BallHamster/Mornigong_display/Kicad_files/Mornigong_disp.kicad_pcb

## KiCad design Kicad_files/Mornigong_disp.kicad_pcb (2026-11-01)

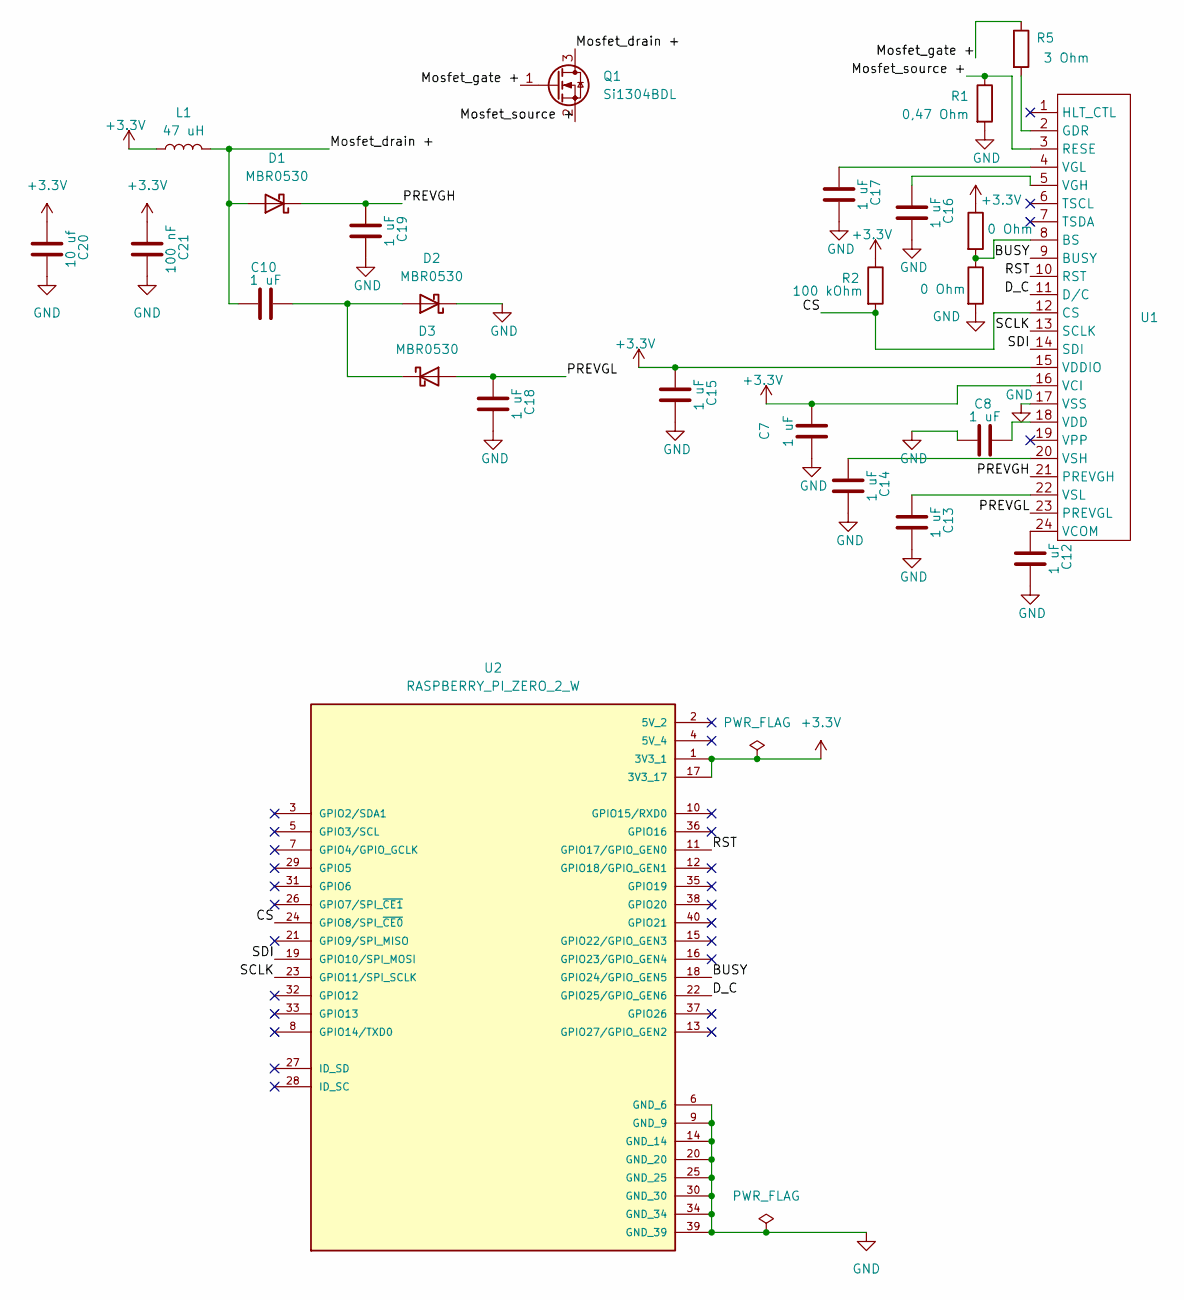
[picture p6: schematic Mornigong_disp.kicad_sch]

Parts:
C7, C8, C10, C12, C13, C14, C15, C16, C17, C18, C19: 1 uF; C_0805_2012Metric_Pad1.18x1.45mm_HandSolder
C20: 10 uf; C_0805_2012Metric_Pad1.18x1.45mm_HandSolder
C21: 100 nF; C_0805_2012Metric_Pad1.18x1.45mm_HandSolder
D1, D2, D3: MBR0530; D_SOD-123
L1: 47 uH; SRR4028
Q1: Si1304BDL; SOT-323_SC-70
R1: 0,47 Ohm; R_0805_2012Metric_Pad1.20x1.40mm_HandSolder
R2: 100 kOhm; R_0805_2012Metric_Pad1.20x1.40mm_HandSolder
R3, R4: 0 Ohm; R_0805_2012Metric_Pad1.20x1.40mm_HandSolder
R5: 3 Ohm; R_0805_2012Metric_Pad1.20x1.40mm_HandSolder
U1: Amphenol_F32Q-1A7x1-11024_1x24-1MP_P0.5mm_Horizontal
U2: RASPBERRY_PI_ZERO_2_W; MODULE_RASPBERRY_PI_ZERO_2_W; PARTREV April 2024

Connections:
+3.3V: C7.2, C15.1, C20.1, C21.1, L1.1, R2.1, R4.1, U1.15 (VDDIO), U1.16 (VCI), U2.1 (3V3_1), U2.17 (3V3_17)
/BUSY: U1.9 (BUSY), U2.18 (GPIO24/GPIO_GEN5)
/CS: R2.2, U1.12 (CS), U2.24 (GPIO8/SPI_~CE0)
/D_C: U1.11 (D/C), U2.22 (GPIO25/GPIO_GEN6)
/Mosfet_drain +: C10.1, D1.2 (A), L1.2, Q1.3 (D)
/Mosfet_gate +: Q1.1 (G), R5.1
/Mosfet_source +: Q1.2 (S), R1.1, U1.3 (RESE)
/PREVGH: C19.1, D1.1 (K), U1.21 (PREVGH)
/PREVGL: C18.1, D3.2 (A), U1.23 (PREVGL)
/RST: U1.10 (RST), U2.11 (GPIO17/GPIO_GEN0)
/SCLK: U1.13 (SCLK), U2.23 (GPIO11/SPI_SCLK)
/SDI: U1.14 (SDI), U2.19 (GPIO10/SPI_MOSI)
GND: C7.1, C8.1, C12.2, C13.2, C14.2, C15.2, C16.2, C17.2, C18.2, C19.2, C20.2, C21.2, D2.1 (K), R1.2, R3.2, U1.17 (VSS), U2.6 (GND_6), U2.9 (GND_9), U2.14 (GND_14), U2.20 (GND_20), U2.25 (GND_25), U2.30 (GND_30), U2.34 (GND_34), U2.39 (GND_39)
unnamed: C10.2, D2.2 (A), D3.1 (K)
unnamed: R3.1, R4.2, U1.8 (BS)
unnamed: R5.2, U1.2 (GDR)
unnamed: C12.1, U1.24 (VCOM)
unnamed: C8.2, U1.18 (VDD)
unnamed: C16.1, U1.5 (VGH)
unnamed: C17.1, U1.4 (VGL)
unnamed: C14.1, U1.20 (VSH)
unnamed: C13.1, U1.22 (VSL)

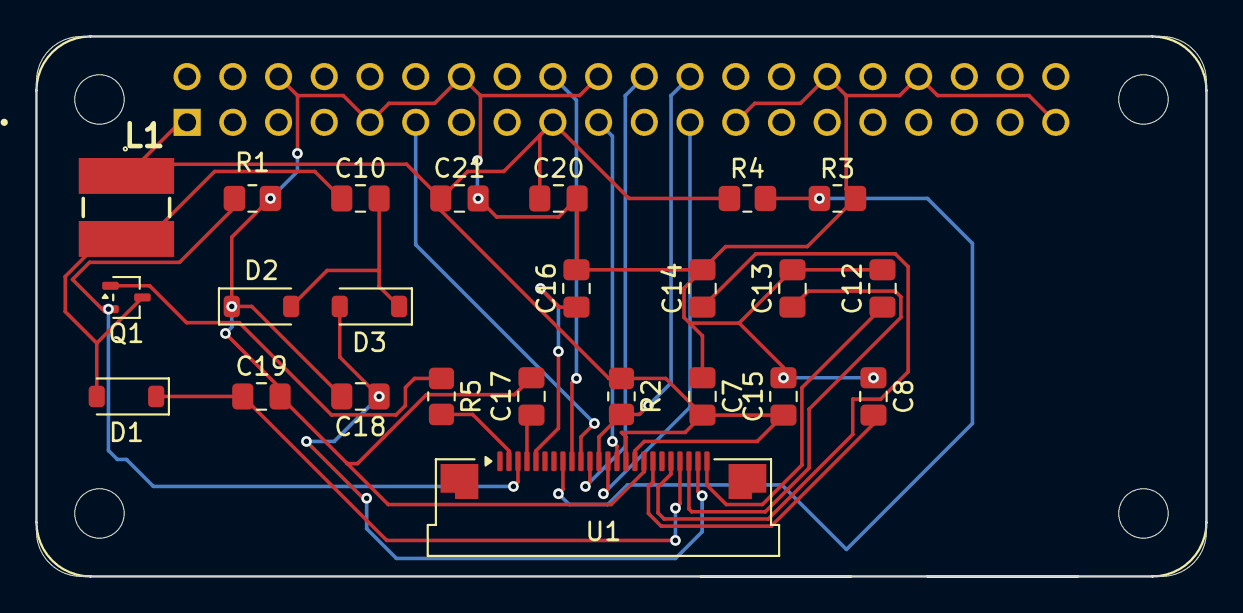
[picture p7: board Mornigong_disp.kicad_pcb from above]

Board: 2 copper layers, 65.0 x 30.0 mm, 25 parts (0 on the bottom side), 22 nets.
