BallHamster/Mornigong_display/(commit log)

2026-11-01 Update README with restart and configuration steps
    Added instructions to restart the Raspberry Pi and access configuration.
2026-11-01 Update BOM by removing optional components
    Removed U2 and several optional components from BOM.
    [BOM.csv]
2026-11-01 Remove R3, R4 from BOM.csv
    Removed R3, R4 entry from BOM.
    [BOM.csv]
2026-11-01 Update FPC csatlakozó to FPC connector in BOM.csv
    [BOM.csv]
2026-11-01 Update Raspberry Pi entry in BOM.csv
    [BOM.csv]
